boons605/MotoGymkhanaRaceTiming/Documentation/STM32-ARM-development-board-STM32F103C8T6.jpg

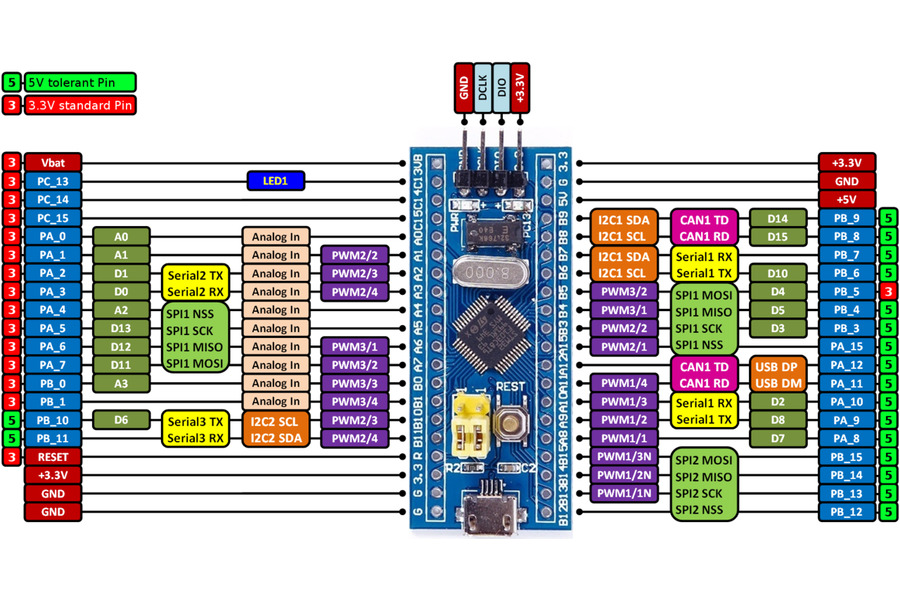
Documentation/STM32-ARM-development-board-STM32F103C8T6.jpg
