boons605/MotoGymkhanaRaceTiming/RiderDetection/Readme.txt

The embedded part of the rider detection was written for the ESP32 platform.
Development hardware used is the ESP32-WROOM-32.
Development environment/framework used is ESP-IDF v4.1-dirty
