boons605/MotoGymkhanaRaceTiming/Timer/README.md

# MotoGymkhanaRaceTiming

This directory contains files for the STM32 software and the supporting PCB
