boons605/MotoGymkhanaRaceTiming/CentralUnit/Deployment/Raspberry-Pi-pinout.png

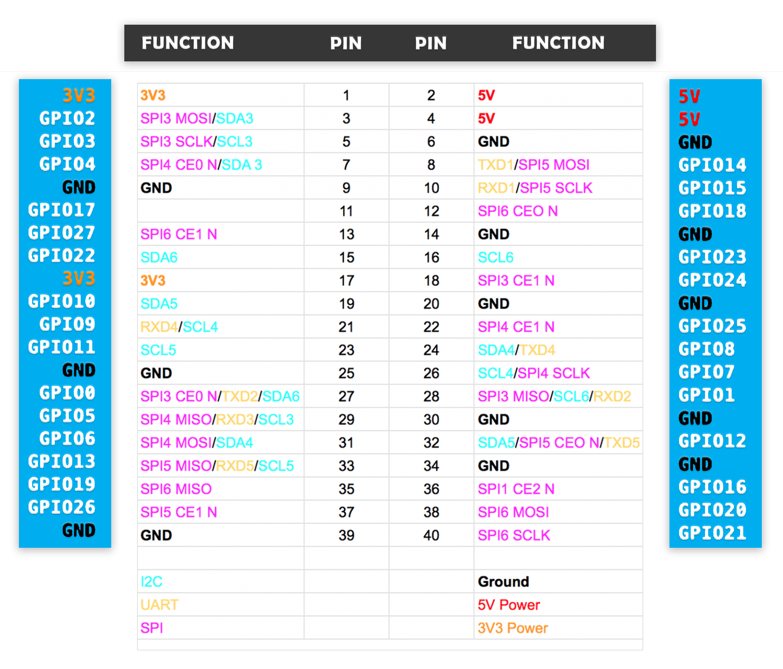
CentralUnit/Deployment/Raspberry-Pi-pinout.png
