boons605/MotoGymkhanaRaceTiming/Documentation/Schematics_STM32-ARM-development-board-STM32F103C8T6.jpg

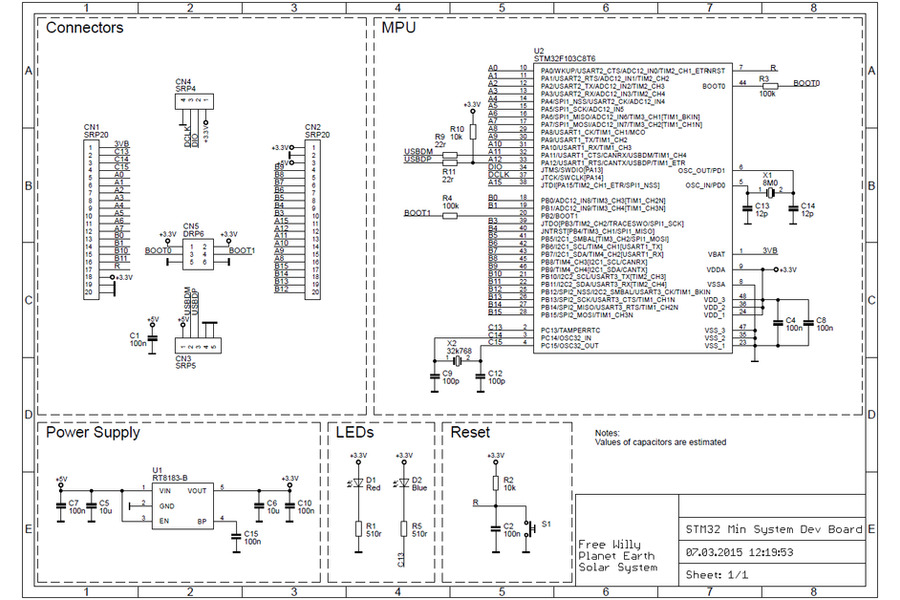
Documentation/Schematics_STM32-ARM-development-board-STM32F103C8T6.jpg
