boons605/MotoGymkhanaRaceTiming/Documentation/Component_diagram.png

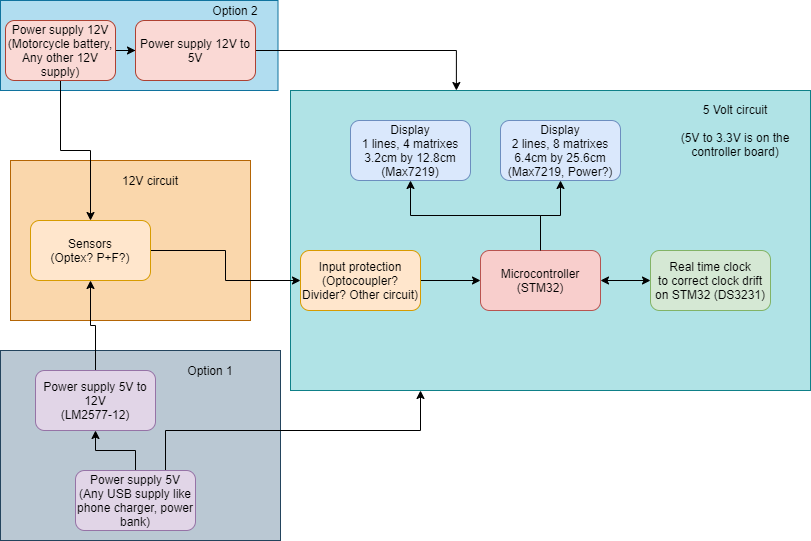
Documentation/Component_diagram.png
