boons605/MotoGymkhanaRaceTiming/(threads)

Thread 3 (2020-05-10):

Dual sensor lap timer

boons605, 2020-05-10:
Dual sensor lap timer:

- Start on interrupt of first sensor
- Stop on interrupt of second sensor

Closed 2020-06-13.

Thread 4 (2020-05-10):

Figure out display options

boons605, 2020-05-10:
Figure out which display options are best

- Large 7-segment (seems a costly option)
- LED Matrix
- E paper?

I-am-not-a-number, 2020-06-22:
ePaper seems an interesting solution!

I was also thinking about building 7 segment displays with LED stripes ... but it seems a lot of effort and I don't have a 3D printer yet.

boons605, 2020-06-22:
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

I've looked at ePaper, and although it seems to be interesting, it is uncertain if the reaction times are low enough and more important: The price. The MAX7219 matrix display solution is almost free and easy to come by. Loads of these displays can be found on AliExpress.

Closed 2022-12-11.

Thread 7 (2020-05-17):

Power supply options - Power bank

boons605, 2020-05-17:
https://www.electronics-lab.com/project/5v-to-12v-step-up-dc-dc-converter/

boons605, 2020-05-17:
https://www.eleccircuit.com/lm2577-5v-to-12v-dc-converter-step-up-voltage-regulator/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

I-am-not-a-number, 2020-06-22:
Hi there,

I'm using an Arduino with an Optex Z2R-400N for a very similar project. The Optex seems to work fine with 9V and the Arduino does, too (the board has a voltage converter for input of 3,3/5 - 12V). The data line of NPN version of the Optex goes to GND, so there's no need to convert the signal down to mircocontroller level ...

Cheers :-)

boons605, 2020-06-22:
Interesting option, the NPN sensor. That might save a few components.
On the other hand: The micorocontroller is protected from accidental wrong connections this way. Accidental 12V would blow it up. Accidental ground won't blow it up now.

I don't see the relevance of the 9V supply: Power banks are easy to come by, battery management is integrated and everyone can charge them. There does not seem to be an equally easy and generic solution for a 9V supply, except for batteries which might not have the greatest capacity to supply and LED display for a longer time.

Most sensors are specced from 10 to 30V. 12V is common enough to be able to use anything that is easily sourceable in any country.

I-am-not-a-number, 2020-07-03:
Thanks for your input!

I have not yet checked how long a 9V battery (that option would save me the power converter parts) would last. I guess it's not long, and I'll go for the power bank option as well.

The goal of my project is the same as yours ... I'm not doing Moto Gymkhana myself, but I'm building this for someone who does.

The timing issue remains to be solved, the milliseconds provided by my arduino (hardware) are off by about 0,04% (measured manually over a longer period of time) and the RTC (DS3231SN) only provides seconds. I thought of aligning "millis()" every seconds with the RTC, but I'm not sure this'll make the timing more accurate ;-)

boons605, 2020-07-04:
I am using the DS3231 to count the seconds and then use a 100us timer based on the 8MHz crystal on the BluePill STM32 board. It helps :-)
You shouldn’t use millis() at all, since it doesn’t increase at 1000us intervals but at 1024us intervals and then compensates for that once every 42ms or so.

The BluePill is cheaper and more powerful than any Arduino board.

0.04% is 24ms over a minute. This solution has been tested to be equally accurate as our €2000,- professional race timing system. Measured with an oscilloscope (PicoScope 4444) it was off by max 80us compared to the simulated trigger.

Anyway. You’re welcome to use my designs or contribute to this project too.

Closed 2020-06-13.

Thread 8 (2020-05-30):

Improve accuracy - 100us timer resolution

boons605, 2020-05-30:
Sometimes a lap is 1ms off.

It seems that this is caused by the fact that TIM2 is set to generate an interrupt every 1ms, but the interrupt of the sensor never comes in exactly at the millisecond boundary.

Therefore, set TIM2 to generate interrupts every 100us and count the interrupts between the start and finish, to account for the remaining fractions of milliseconds and to avoid letting this remainder add up and lead to a 1ms drift over a few rounds.

Closed 2020-06-13.

Thread 9 (2020-06-03):

PCB improvements

boons605, 2020-06-03:
- Add buttons
- Add resistors for voltage divider for LM2577T-ADJ
- Change footprints for display connectors to straight connectors
-

Closed 2021-04-04.

Thread 10 (2020-12-28):

Set up central unit scaffold

CptMalfunction, 2020-12-28:
The general architecture of the system will have a central unit running on a pc, and several edge units running on less powerful hardware.

These edge units are

- Timer: registers when something crosses the detector and returns a timestamp
- ID: registers a driver's bluetooth dongle nearby and sends bluetooth id
- maybe more?

The central unit is responsible for:

- configuring the edge units (for example: which BL ids are riders)
- notifying edge units of events (for example: a rider has left the track)
- consolidating edge unit data into race events (for example:  ID unit registers rider, timing unit registers time, combine into a finish/start time for that rider)
- saving race results

The scaffold should include:

- A CLI project with a version command
- A Timer project that specifies the timing unit interface
- An Id project that specifies the ID unit interface
- A RaceManagement project as a placeholder

Project should be written in C# in .netcore 3.1

Closed 2020-12-30.

Thread 12 (2020-12-30):

Implement event matching

CptMalfunction, 2020-12-30:
The system is going to track the state of the race by events coming in from the timing and rider id units. This means we will have to match timing events to rider id events to be able to couple lap times to riders and to detect when riders leave the track without hitting the end gate.

A race has 4 primitive events:
- start rider id (when a rider is picked up in the start box)
- start timing event (when a rider triggers the timer at the start box)
- end rider id
- end timer

A race has 3 derived events:
- Lap end (when we have matching end events)
- Finish (when we have a matching set of the 4 primitives)
- DNF (when we have matches for the start events, but no ending events)

A rider has 3 possible states:
- Waiting for start (when we have a start rider id event)
- On track (we have a start rider id and a start timer)
- Off track (we have a finish or DNF event for the rider)
-- Off track means our system has stopped keeping track, a rider may enter the start box to be 'Waiting' again

We assume these things about the primitive events:
- start rider id always happens before start timing. Since the rider must calmly enter the start box in a race
- matching end id and timer events may happen in either order (if the id range is much bigger than the stop box)
- matching end id and timer events happen at most 10 seconds apart
- there will be no end id events for riders not currently on track (we can notify the unit on which ids to report when riders start)
- there will be no start id events for riders who are not lining up for the start box (tell riders to keep a safe distance)

The algorithm for keeping track of riders will be:

On start rider id event:
Add a new Waiting rider to the queue

On start timer event:
Take the oldest Waiting rider from the queue, match to the new timer event.
Set rider to On track
if there is no waiting rider, disregard event

On end timer event:
Match to closest end id event (+/-10 secs at most)
if there is no match, store event
if there is a match, issue a new Lap end event

On end id event
Match to closest end timer event (+/-10 secs at most)
if there is no match, store event
if there is a match, issue a new Lap end event

On Lap end event:
Match to riders currently on track
If it matches to the oldest on track, Issue a Finish event
If it matches to a younger on track rider, issue Finish event for matched driver. Issue DNF events for all older on track drivers

This algorithm should be implement in RaceManagement. Covered by unit tests and it should be possible to run a simulated race from the CLI by providing an events list in txt form

boons605, 2020-12-31:
As discussed on discord:

- Permission to start, rider ID unit should be able to control a traffic light for feedback to the rider.
- Result display event to timing unit or generic display unit (separate interface? To allow display-only devices)
- Single sensor operation, for example for world courses, online EC, GP8 competitions.

boons605, 2021-01-01:
What to do on a failure of the ID unit or timer unit communication?

On some events, we may be able to recover by restarting the communication, or restarting the application.
Should we store 'current' runs somewhere in order to facilitate sort of graceful restart?

CptMalfunction, 2021-01-09:
Added events for rider ready to start and rider finished to allow for a simple 'ready' signal at start and time display at finish

Closed 2021-01-24.

Thread 13 (2020-12-30):

Implement timer communication

boons605, 2020-12-30:
The timer needs to be able to communicate over UART

For now, 2 functions are sufficient:

* Timestamp communication
  * Unsollicited
  * Include data about sensor (start, stop or lap finished for lap timer operation mode)
* Keepalive to monitor communication
  * Two-way communication
  * No effect, other than for the central unit to monitor communication
  * Contains information about the configuration of the timer (number of sensors, RTC present or not, operation mode)

Closed 2021-04-04.

Thread 14 (2020-12-30):

Communication framework

boons605, 2020-12-30:
Implementation of communication with field units

* Must support Serial connection
* Must support Xbee communcation
* Must abstract Xbee communication and serial communcation to the point where the interface consists of 3 items
  * DataReceived event
  * Failure event
  * SendData method, accepting a byte array

Closed 2021-01-03.

Thread 15 (2020-12-31):

Web service for UI?

boons605, 2020-12-31:
We talked about a web interface for the UI. Creating this issue to collect ideas and links to interesting resources.

- .NET Core web service on Linux (Pi) https://docs.microsoft.com/en-us/aspnet/core/host-and-deploy/linux-nginx?view=aspnetcore-5.0
- Web API in .NET Core
https://docs.microsoft.com/en-us/aspnet/core/tutorials/first-web-api?view=aspnetcore-5.0&tabs=visual-studio

CptMalfunction, 2021-03-07:
Currently im thinking we split this up in 2 projects. The actual api in asp.net core, and the web ui in a blazor project

CptMalfunction, 2021-03-28:
So now that i've gotten a single endpoint up and running what endpoints do we want? I've got a few here:

- Race monitoring endpoints:
-- GET /RaceState: returns a json that contains riders on track, riders waiting for start. And any device events waitign for a match
-- GET /Laps: returns a json with a list of all the driven laps (including DNF) since the unit was turned on
-- GET /BestLaps: Returns a json with the best lap per driver, sorted by lap time

- Management endpoints:
-- POST /AddRiders: takes a json with a list of all riders that should be tracked by the system
-- DELETE /Rider: takes a rider id as a query param and stops tracking this rider for the current race
-- POST /Config: takes a json that specifies a full race config (id units and timing unit details). Clears the current race state and (re) starts the race with the new settings
-- GET /Lock: takes 'open' or 'closed' as a query parameter. If closed no new riders can start

boons605, 2021-03-28:
I would like to opt for the option to integrate DSQ and Penalty points and to register those as events with a timestamp (and to be able to undo those and therefore to list them in order of time). Penalty point events could have an amount (configurable?) category?

Could be really helpful in identifying what exactly went wrong: For the rider to improve themselves and when handling disputes after the race.

Romke Boonstra

Sent from my iPhone

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

boons605, 2021-03-28:
Maybe add some management operations for listing riders, modifying riders.

Modifying race results maybe?

CptMalfunction, 2021-04-11:
I think ill make the management endpoints into a differnt issue. For now im just doing the andpoints for the state and the laps

Closed 2021-04-22.

Thread 17 (2021-01-02):

Implement Rider ID device communication

boons605, 2021-01-02:
Implementation of Rider ID device communication for the ESP32 based iBeacon rider identification.

The scaffold was already set up in issue #10, now implementation of rider ID unit interface is to be written:

* Establish communication
* Keepalive every 1000ms, unless a message is received during that time
* Allow adding and removing of known beacons
* Define conditions to consider rider 'in range' (have configurable detection range?)

Closed 2021-01-31.

Thread 18 (2021-01-02):

Data model

boons605, 2021-01-02:
While in issue #12 the event matching is implemented and in issue #17 the rider ID communication is implemented, the idea arose to keep the data model in a separate project, to allow use by future components.

Uses for this could be:

* Storing results in a database
* Communication in a UI
* REST API
* Publication
* Future expansions

For this, we need to agree upon a suitable data model at least we have:

* Rider
  * Has 1: Beacon
  * Has 1: Name
* Beacon
  * Has 1: BLE identifier (6 bytes)
  * Has 1: Transmit power (signal strength at 1m)
  * Has 1: Transmit power correction factor (for cheap chinese beacons)
  * Has 1: Detected signal strength
  * Belongs to 1 rider
* Race Event:
  * Is either a: Timestamp, Rider ID, Penalty event, DNF Events, DSQ Event
  * Always has 1: Date/time received (for rough linking of future additional events)
    * Timestamp Event
      * Has 1: timestamp in microseconds
      * Has 1: Sensor ID (start or stop)
    * Rider ID event
      * Has 1: Beacon
      * Has 1: Sensor ID
    * DNF Event
    * Penalty Event (not implemented for now)
      * Has 1: Type (configurable?)
    * DSQ Event (not implemented for now)
* Run
  * Has 1 Rider
  * Has a list of Race Events
  * Date/Time created
  * Date/Time last updated
* RaceDay? (not for now)
* Competition? (not for now)

Closed 2021-01-31.

Thread 19 (2021-01-02):

Carrier PCB for Rider ID unit

boons605, 2021-01-02:
For the Rider ID unit, we need a carrier PCB to carry the ESP32 and, for one of the gates, the Xbee module.

The PCB should:

* Carry the ESP32
* Carry the Xbee module
* Provide an option for direct serial connection to the central unit
* Have a MicroUSB connection for power
* Be able to control an LED light?

Closed 2021-04-04.

Thread 29 (2021-03-15):

Central unit PCB

boons605, 2021-03-15:
PCB for some interconnections between components:

* Carries an Xbee module
* Has a 40-pin header to connect to the RPi
* Has an Rx/Tx/Gnd header to connect to the timer unit
* Has a connection to the terminal port of the RPi
* LEDs for the Xbee module RSSI and ASSOC
* Power LED

Closed 2021-04-04.

Thread 31 (2021-04-04):

Race management with business logic

boons605, 2021-04-04:
Features needed for usability at a race day:

Created Issue #33
> * Allow user-generated DNF

Created Issue #32
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

Created issue #35
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

Created Issue #36
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

Created Issue #34
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

boons605, 2021-04-04:
Created new issues to split up this issue

Closed 2021-04-04.

Thread 58 (2021-05-22):

Interact with gymkhana website

CptMalfunction, 2021-05-22:
For documentation on available endpojnts see timing.motogymkhana.nl/handleiding_scorebord.pdf.

At https://timing.motogymkhana.nl/ there is a web api that can show times and who is currently on track. We can populate this page by using the state from the racetracking endpoints available on the web api of the central unit.

We should implement a small auxiliary program that polls the web api of the central unit and posts results to the gymkhana website.

Acceptance criteria:

- When a new rider enters the track the "Nu aan het rijden" table is updated
- When a rider finishes a lap the rider is removed from the "Nu aan het rijden" table and the time is added to both time tables
- When a rider receives a DNF the rider is removed from the "Nu aan het rijden" table and a DNF row is added to the timing tables
- When a rider receives a DSQ the rider is removed from the "Nu aan het rijden" table and DSQ row is added to the timing tables

Notes: there does not appear to be a way to clear the board. Should we add such an endpoint and clear on startup?

CptMalfunction, 2021-05-23:
> Up for discussion with Paul:
>
> Why aren't DNFs or DSQs registered as time with the attribut 'DNF' or 'DSQ'? Wouldn't you want to have these times registered anyway? The rider has started and there should be some kind of evidence that this has taken place.

The penalty endpoint allows you to record dnfs and dsq's. Should really be in the acceptance criteria

Closed 2022-12-11.

Thread 76 (2023-11-17):

Picking riders from ordered start list

boons605, 2023-11-17:
This function is already in, but the issue is created anyway, to be able to record how this is verified

Als wedstrijdleider wil ik rijders uit een lijst kunnen kiezen die in het startvak staan om ze toestemming te geven te starten

Closed 2024-04-14.

Thread 77 (2023-11-17):

Changing order of start list

boons605, 2023-11-17:
This function is already in, but the issue is created anyway, to be able to record how this is verified

Als wedstrijdleider wil ik last minute wijzigingen in de startvolgorde kunnen aanbrengen, want motoren gaan stuk

Closed 2024-02-18.

Thread 78 (2023-11-17):

Stop box functions

boons605, 2023-11-17:
This function is already in, but the issue is created anyway, to be able to record how this is verified

Als wedstrijdleider wil ik de eerst gestarte rijder die in het parcours is gepresenteerd krijgen zodra er een rijder in het stopvak verschijnt want dat is de meest waarschijnlijke optie

Als wedstrijdleider wil ik, indien het niet de eerst gestarte rijder is die in het stopvak staat, kunnen kiezen uit rijders in het parcours

Als wedstrijdleider wil ik een timestamp kunnen negeren, want valse detecties komen voor

Closed 2024-04-14.

Thread 79 (2023-11-17):

Adding penalties while racing

boons605, 2023-11-17:
Als wedstrijdleider wil ik tijdens het rijden strafpunten kunnen invoeren, zodat het resultaat direct de strafpunten bevat

Als wedstrijdleider wil ik kort na het finishen strafpunten kunnen invoeren, omdat mensen doorschieten in het stopvak of op andere wijze strafpunten kunnen verdienen

CptMalfunction, 2023-11-19:
Het is al mogelijk om:

- DNF te geven via POST /DNF
- DSQ te geven via POST /DSQ
- Strafseconden te geven via Post /Penalty

Al deze penalties worden teogepast op de huidige lap van de rider als deze nu aan het rijden is, of op het meest recente gereden lap. Daar hoeft de ui geen keuze in te maken. Als de endpoints aangeroepen worden tijden een lap dan komt de penalty op dat lap anders komen de penalties op het meest recente lap

Als een lap afgerond is dan kunnen de panelties in het lap object uitgelezen worden uit GET /Laps of GET /BestLapsByRider.

Wat er nog ontbreekt is een endpoint om de penalties uit te lezen die op het huidige lap toegepast worden terwijl dat lap nog bezig is. Dat ga ik maken voor deze issue

CptMalfunction, 2023-11-19:
Nieuw endpoint:

- GET /Penalties
- Geeft alle openstaande penalties terug voor rijders die nu aan een lap bezig zijn.
- Output: ```{
    "0694d10b-3cc4-424b-823a-2b45b1b3455f": [
        {
            "reason": "",
            "seconds": 1,
            "staffName": "UI",
            "time": "2023-11-19T15:44:03.7680777+01:00",
            "eventId": "5b148b1b-c83c-4238-9e12-fab9d80a146c",
            "rider": {
                "name": "Test",
                "id": "0694d10b-3cc4-424b-823a-2b45b1b3455f"
            },
            "type": "PenaltyEvent"
        }
    ]
}```

Om het aantal seconden o[ te halen zou je zoiets doen als `penalties['rider guid'][0].seconds`

rbf660, 2023-11-20:
Is het ook mogelijk om status van DSQ penalty toe te voegen?

Closed 2024-02-18.

Thread 80 (2023-11-17):

Multiple penalty types to be defined

boons605, 2023-11-17:
Als wedstrijdleider wil ik meerdere soorten penalties kunnen definiëren met meerdere kenmerken, omdat verschillende vergrijpen verschillende sancties kennen.
•	Kleur (geel/rood)
•	Seconden (1/3)

Closed 2024-04-14.

Thread 81 (2023-11-17):

Rider feedback in stopbox

boons605, 2023-11-17:
Als rijder wil ik direct terugkoppeling over de gereden tijd zonder strafpunten, want er kan discussie zijn onder de wedstrijdleiding

Control display hardware

Maybe make time available on a separate endpoint/page to allow the use of an iPad or similar device as a rider display?

Closed 2024-04-14.

Thread 82 (2023-11-17):

State restore after startup

boons605, 2023-11-17:
Als wedstrijdleider wil ik de toestand van het systeem kunnen herstellen na een herstart, omdat kabels losraken of rijders de apparatuur om rijden

- Currently running laps shall be restored
   - Including penalties
- Previous laps shall be restored
- Start list/rider list shall be restored

Closed 2024-04-14.

Thread 88 (2023-12-09):

ongebruikte end time events weg gooien

CptMalfunction, 2023-12-09:
Het is nu niet mogelijk om end time events die zeker niet gebruikt gaan worden permanent te verwijderen van het systeem. Het wordt dan voor de ui steeds moeilijker om de end time events te vinden die wel horen bij de rijders op de baan.

de api krijgt dit nieuwe endpoint:

- DELETE /PendingTime?eventId=<guid>

In de query parameter gaat het event id van een event uit het GET /PendingTimes endpoint. Na het aanroepen van dit DELETE endpoint zal het event met het aangegeven id niet meer terug komen in de response van GET /PendingTimes

Closed 2023-12-09.

Thread 89 (2024-02-17):

Data from timer received twice

boons605, 2024-02-17:
Weird issue with timestamps being 'received' twice with the same data, one immediately after matching time and rider

1. Clear rider for start
2. Trigger gate to Start rider
3. Trigger gate to stop rider
4. Confirm finish time

`
2024-02-17 19:30:41,614 [4] INFO  RaceManagement.RaceManager [(null)] - Rider Claud van Gessel can start
2024-02-17 19:30:41,706 [12] INFO  WebAPI.Controllers.RaceTrackingController [(null)] - addin rider Richard van Schouwenburg, 6522e607-0eee-4e8f-9ea7-898007ad4eb0
2024-02-17 19:30:48,438 [6] INFO  Communication.AbstractCommunicatingUnit [(null)] - Got timestamp for timer: Command type 101;
Data length: 5
CRC: 17534
Data: 30-01-57-BA-01

2024-02-17 19:30:48,460 [7] INFO  Communication.AbstractCommunicatingUnit [(null)] - Triggering timing event for timerUnit
2024-02-17 19:30:48,461 [7] INFO  Communication.AbstractCommunicatingUnit [(null)] - Triggered timing event for timerUnit
2024-02-17 19:30:48,465 [4] INFO  RaceManagement.RaceTracker [(null)] - Rider f96116e7-639b-45f1-aae0-1f3d7c52fe5b is now on track with timestamp 3126264112
2024-02-17 19:30:48,472 [4] INFO  RaceManagement.RaceManager [(null)] - Start box is empty
2024-02-17 19:30:53,786 [6] INFO  Communication.AbstractCommunicatingUnit [(null)] - Got timestamp for timer: Command type 101;
Data length: 5
CRC: 59881
Data: 4C-B1-A8-BA-02

2024-02-17 19:30:53,803 [7] INFO  Communication.AbstractCommunicatingUnit [(null)] - Triggering timing event for timerUnit
2024-02-17 19:30:53,804 [7] INFO  Communication.AbstractCommunicatingUnit [(null)] - Triggered timing event for timerUnit
2024-02-17 19:31:06,861 [4] INFO  RaceManagement.RaceManager [(null)] - Rider Claud van Gessel finished with a lap time of 5353500 microseconds
2024-02-17 19:31:06,893 [6] INFO  Communication.AbstractCommunicatingUnit [(null)] - Got timestamp for timer: Command type 101;
Data length: 5
CRC: 59881
Data: 4C-B1-A8-BA-02

2024-02-17 19:31:06,895 [7] INFO  Communication.AbstractCommunicatingUnit [(null)] - Triggering timing event for timerUnit
2024-02-17 19:31:06,896 [7] INFO  Communication.AbstractCommunicatingUnit [(null)] - Triggered timing event for timerUnit
2024-02-17 19:31:06,896 [4] INFO  RaceManagement.RaceTracker [(null)] - Discarding timestamp from gate 2 at 3131617612 us, no riders on track
^C
ubuntu@ubuntu:~/motogymkhana$
`

boons605, 2024-02-18:
Fixed in #83

Closed 2024-02-18.
