boons605/MotoGymkhanaRaceTiming/RiderDetection/PCB/RiderDetection/RiderDetection.kicad_pcb

## KiCad design RiderDetection/PCB/RiderDetection/RiderDetection.kicad_pcb (2021-03-23)

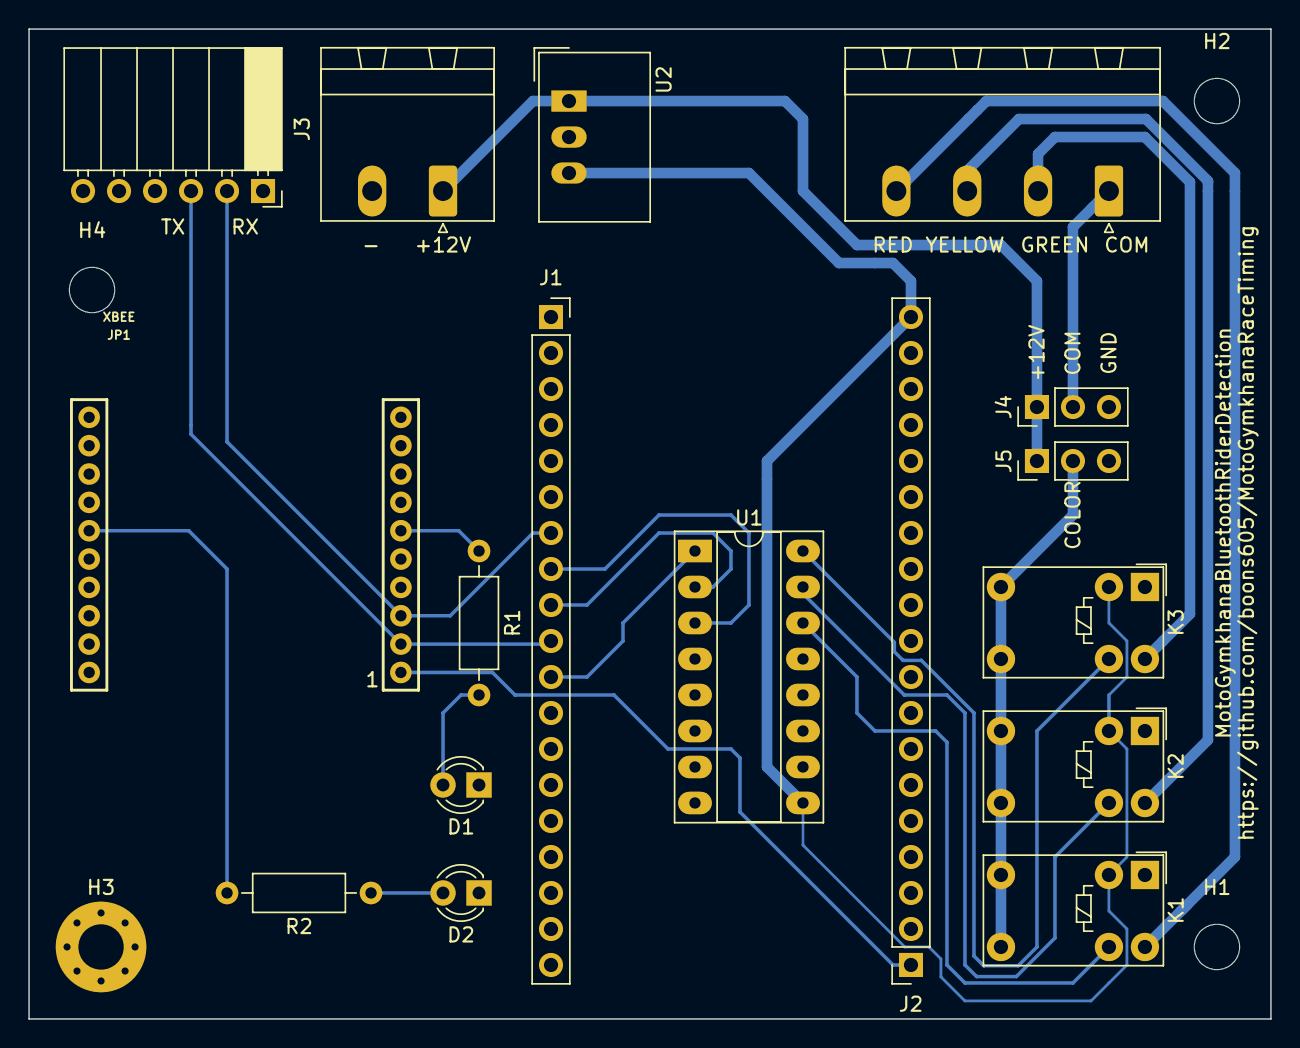
[picture p5: board RiderDetection.kicad_pcb from above]

Board: 2 copper layers, 87.6 x 69.8 mm, 21 parts (0 on the bottom side), 21 nets.

Parts:
D1, D2: LED; LED_D3.0mm
H1, H2, H4: MountingHole; MountingHole_3.2mm_M3
H3: MountingHole_Pad; MountingHole_3.2mm_M3_Pad_Via
J1, J2: Conn_01x19; PinSocket_1x19_P2.54mm_Vertical
J3: Conn_01x06; PinSocket_1x06_P2.54mm_Horizontal
J4, J5: Conn_01x03_Male; PinHeader_1x03_P2.54mm_Vertical
JP1: XBEE
K1, K2, K3: G5V-1; Relay_SPDT_Omron_G5V-1
PWR0: Screw_Terminal_01x02; PhoenixContact_MSTBA_2,5_2-G_1x02_P5.00mm_Horizontal
R1, R2: 330R; R_Axial_DIN0207_L6.3mm_D2.5mm_P10.16mm_Horizontal
STARTLIGHT0: Screw_Terminal_01x04; PhoenixContact_MSTBA_2,5_4-G_1x04_P5.00mm_Horizontal
U1: ULN2003A; DIP-16_W7.62mm_Socket_LongPads
U2: TSR_1-2450; Converter_DCDC_TRACO_TSR-1_THT

Connections:
+3V3: J2.1, JP1.1
+5V: J2.19, K1.2, K2.2, K3.2, U1.9, U2.3
+12V: J4.1, J5.1, PWR0.1, U2.1
COL_GRN: K3.10, STARTLIGHT0.2
COL_RD: K1.10, STARTLIGHT0.4
COL_YW: K2.10, STARTLIGHT0.3
GND: D1.1, D2.1, H3.1, J1.19, J3.6, J4.3, J5.3, JP1.10, PWR0.2, U1.8, U2.2
unnamed: D1.2, R1.2
unnamed: D2.2, R2.1
unnamed: J1.8, U1.3
unnamed: J1.9, U1.2
unnamed: J1.11, U1.1
unnamed: JP1.6, R1.1
unnamed: JP1.15, R2.2
unnamed: K1.9, U1.14
unnamed: K2.9, U1.15
unnamed: K3.9, U1.16
RXD: J1.7, J3.2, JP1.3
START_COLOR_COM: J5.2, K1.5, K1.6, K2.5, K2.6, K3.5, K3.6
START_COM: J4.2, STARTLIGHT0.1
TXD: J1.10, J3.3, JP1.2
