boons605/MotoGymkhanaRaceTiming/Timer/PCB/MotoGymkhanaRaceTiming/MotoGymkhanaRaceTiming.kicad_pcb

## KiCad design Timer/PCB/MotoGymkhanaRaceTiming/MotoGymkhanaRaceTiming.kicad_pcb (2021-03-23)

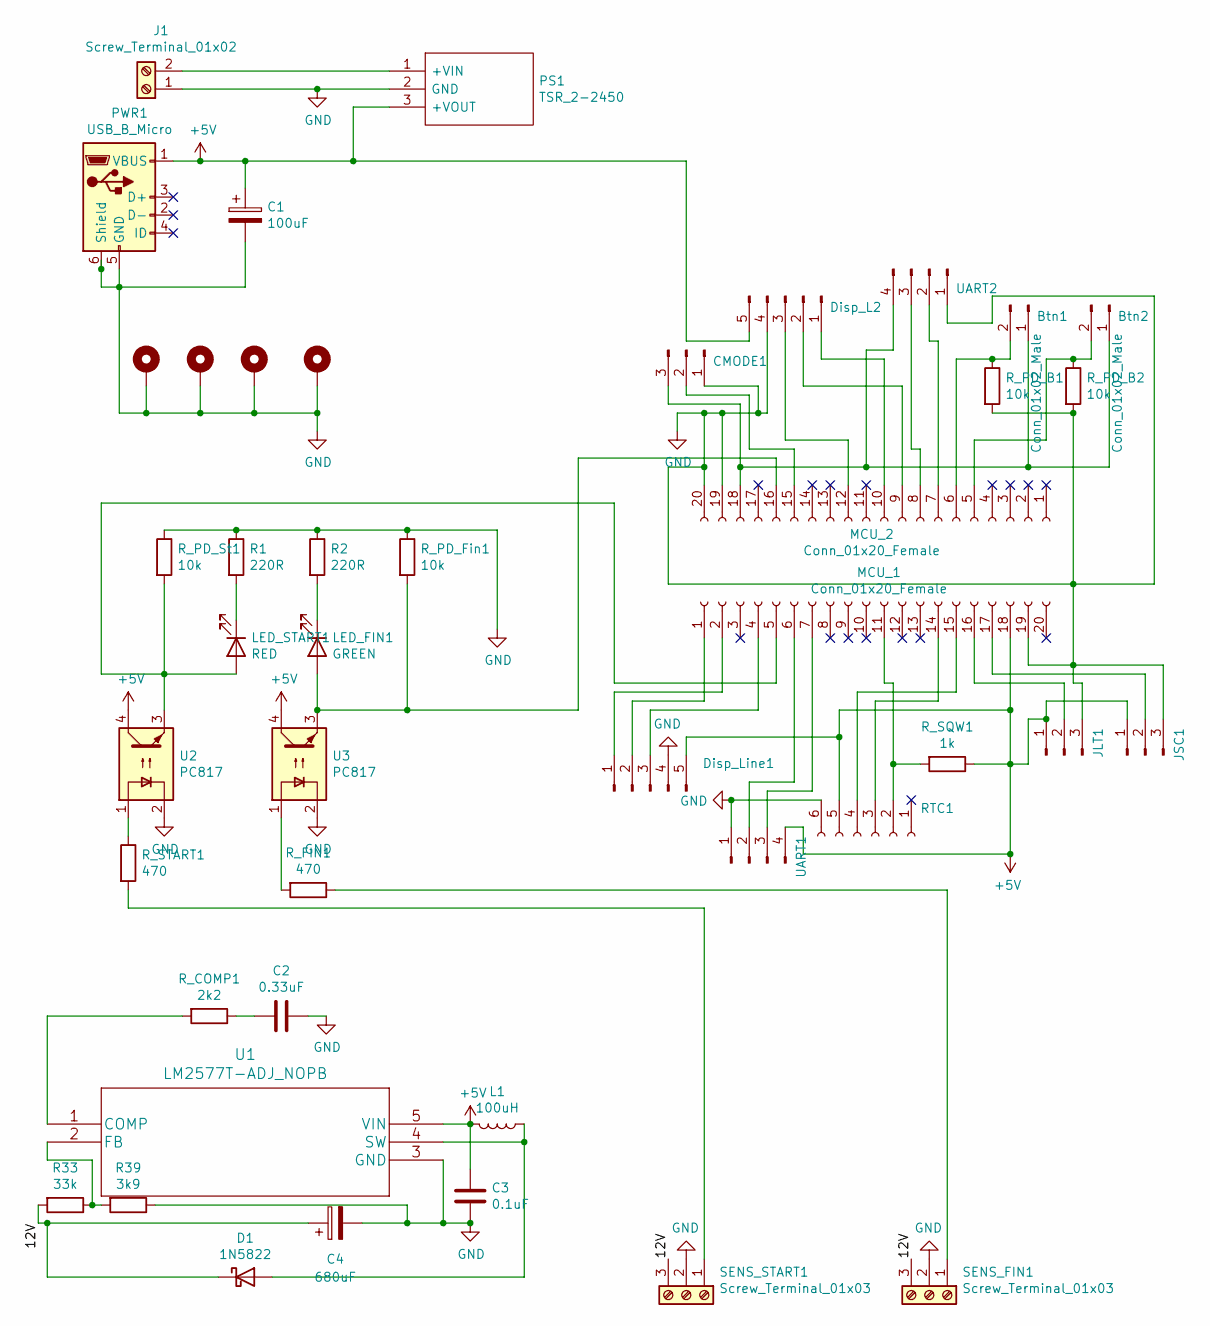
[picture p6: schematic MotoGymkhanaRaceTiming.sch]

Parts:
Btn1, Btn2: Conn_01x02_Male; PinHeader_1x02_P2.54mm_Vertical
C1: 100uF; CP_Radial_D8.0mm_P5.00mm
C2: 0.33uF; C_Disc_D4.7mm_W2.5mm_P5.00mm
C3: 0.1uF; C_Disc_D4.7mm_W2.5mm_P5.00mm
C4: 680uF; CP_Radial_D10.0mm_P5.00mm
CMODE1: Conn_01x03_Male; PinHeader_1x03_P2.54mm_Vertical
D1: 1N5822; D_DO-201AD_P15.24mm_Horizontal
Disp_L2: Conn_01x05_Male; DisplayLineConnector
Disp_Line1: Conn_01x05_Male; DisplayLineConnector
H1, H2, H3, H4: MountingHole_Pad; MountingHole_3.2mm_M3_Pad_Via
J1: Screw_Terminal_01x02; PhoenixContact_MSTBA_2,5_2-G_1x02_P5.00mm_Horizontal
JLT1: Conn_01x03_Male; PinHeader_1x03_P2.54mm_Vertical
JSC1: Conn_01x03_Male; PinHeader_1x03_P2.54mm_Vertical
L1: 100uH; L_Radial_D7.0mm_P3.00mm
LED_FIN1: GREEN; LED_D5.0mm
LED_START1: RED; LED_D5.0mm
MCU_1, MCU_2: Conn_01x20_Female; PinSocket_1x20_P2.54mm_Vertical
PS1: TSR_2-2450; TSR-2; Manufacturer_Part_Number TSR 2-2450; Mouser Part Number 495-TSR2-2450
PWR1: USB_B_Micro; USB_Micro-B_Wuerth_614105150721_Vertical_CircularHoles
R1, R2: 220R; R_Axial_DIN0207_L6.3mm_D2.5mm_P10.16mm_Horizontal
R33: 33k; R_Axial_DIN0207_L6.3mm_D2.5mm_P10.16mm_Horizontal
R39: 3k9; R_Axial_DIN0207_L6.3mm_D2.5mm_P10.16mm_Horizontal
RTC1: Conn_01x06_Female; RTC_Socket
R_COMP1: 2k2; R_Axial_DIN0207_L6.3mm_D2.5mm_P10.16mm_Horizontal
R_FIN1: 470; R_Axial_DIN0207_L6.3mm_D2.5mm_P10.16mm_Horizontal
R_PD_B1, R_PD_B2: 10k; R_Axial_DIN0207_L6.3mm_D2.5mm_P10.16mm_Horizontal
R_PD_Fin1: 10k; R_Axial_DIN0207_L6.3mm_D2.5mm_P10.16mm_Horizontal
R_PD_St1: 10k; R_Axial_DIN0207_L6.3mm_D2.5mm_P10.16mm_Horizontal
R_SQW1: 1k; R_Axial_DIN0207_L6.3mm_D2.5mm_P10.16mm_Horizontal
R_START1: 470; R_Axial_DIN0207_L6.3mm_D2.5mm_P10.16mm_Horizontal
SENS_FIN1: Screw_Terminal_01x03; SensorConnector
SENS_START1: Screw_Terminal_01x03; SensorConnector
U1: LM2577T-ADJ_NOPB; LM2577T-ADJ&slash_NOPB
U2, U3: PC817; DIP-4_W7.62mm
UART1, UART2: Conn_01x04_Male; UART

Connections:
+5V: C1.1, C3.1, Disp_L2.5, Disp_Line1.5, JLT1.1, JSC1.1, L1.2, MCU_1.18, PS1.3 (+VOUT), PWR1.1 (VBUS), RTC1.5, R_SQW1.1, U1.5 (VIN), U2.4, U3.4, UART1.4
/12V: C4.1, D1.1 (K), R33.2, SENS_FIN1.3, SENS_START1.3
GND: C1.2, C2.1, C3.2, C4.2, CMODE1.1, Disp_L2.4, Disp_Line1.4, H1.1, H2.1, H3.1, H4.1, J1.1, JLT1.3, JSC1.3, MCU_1.19, MCU_2.19, MCU_2.20, PS1.2 (GND), PWR1.5 (GND), PWR1.6 (Shield), R1.1, R2.1, R39.1, RTC1.6, R_PD_B1.2, R_PD_B2.2, R_PD_Fin1.1, R_PD_St1.1, SENS_FIN1.2, SENS_START1.2, U1.3 (GND), U2.2, U3.2, UART1.1, UART2.1
unnamed: Btn1.1, Btn2.1, CMODE1.3, MCU_2.18, UART2.4
unnamed: Btn1.2, MCU_2.6, R_PD_B1.1
unnamed: Btn2.2, MCU_2.5, R_PD_B2.1
unnamed: C2.2, R_COMP1.1
unnamed: CMODE1.2, MCU_2.15
unnamed: D1.2 (A), L1.1, U1.4 (SW)
unnamed: Disp_L2.1, MCU_2.10
unnamed: Disp_L2.2, MCU_2.9
unnamed: Disp_L2.3, MCU_2.12
unnamed: Disp_Line1.1, MCU_1.2
unnamed: Disp_Line1.2, MCU_1.1
unnamed: Disp_Line1.3, MCU_1.4
unnamed: J1.2, PS1.1 (+VIN)
unnamed: JLT1.2, MCU_1.16
unnamed: JSC1.2, MCU_1.17
unnamed: LED_FIN1.1 (K), R2.2
unnamed: LED_FIN1.2 (A), MCU_2.16, R_PD_Fin1.2, U3.3
unnamed: LED_START1.1 (K), R1.2
unnamed: LED_START1.2 (A), MCU_1.5, R_PD_St1.2, U2.3
unnamed: MCU_1.6, UART1.2
unnamed: MCU_1.7, UART1.3
unnamed: MCU_1.11, RTC1.2, R_SQW1.2
unnamed: MCU_1.14, RTC1.3
unnamed: MCU_1.15, RTC1.4
unnamed: MCU_2.7, UART2.2
unnamed: MCU_2.8, UART2.3
unnamed: R33.1, R39.2, U1.2 (FB)
unnamed: R_COMP1.2, U1.1 (COMP)
unnamed: R_FIN1.1, SENS_FIN1.1
unnamed: R_FIN1.2, U3.1
unnamed: R_START1.1, U2.1
unnamed: R_START1.2, SENS_START1.1

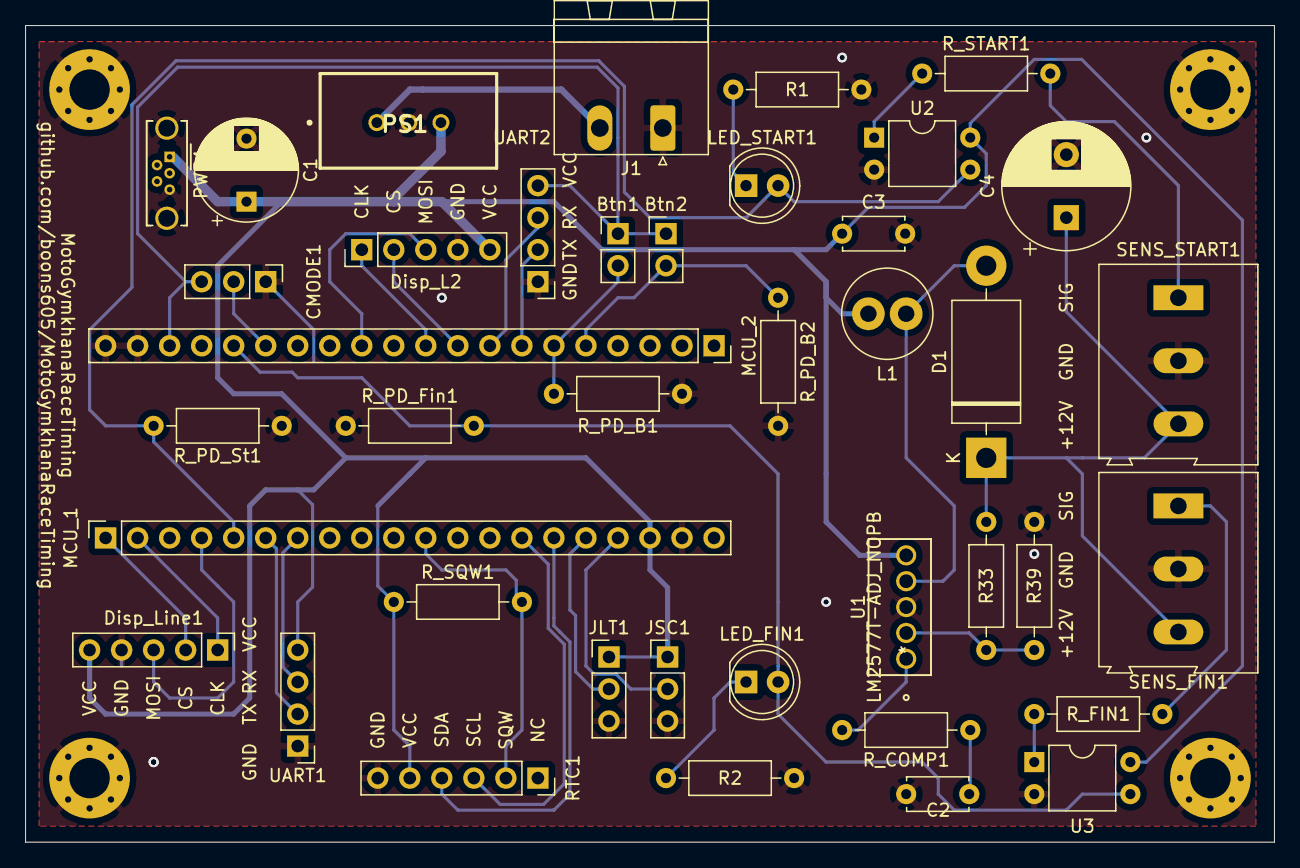
[picture p7: board MotoGymkhanaRaceTiming.kicad_pcb from above]

Board: 2 copper layers, 99.1 x 64.8 mm, 44 parts (0 on the bottom side), 35 nets.
