boons605/MotoGymkhanaRaceTiming/CentralUnit/PCB/CentralUnit/CentralUnit.kicad_pcb

## KiCad design CentralUnit/PCB/CentralUnit/CentralUnit.kicad_pcb (2021-03-23)

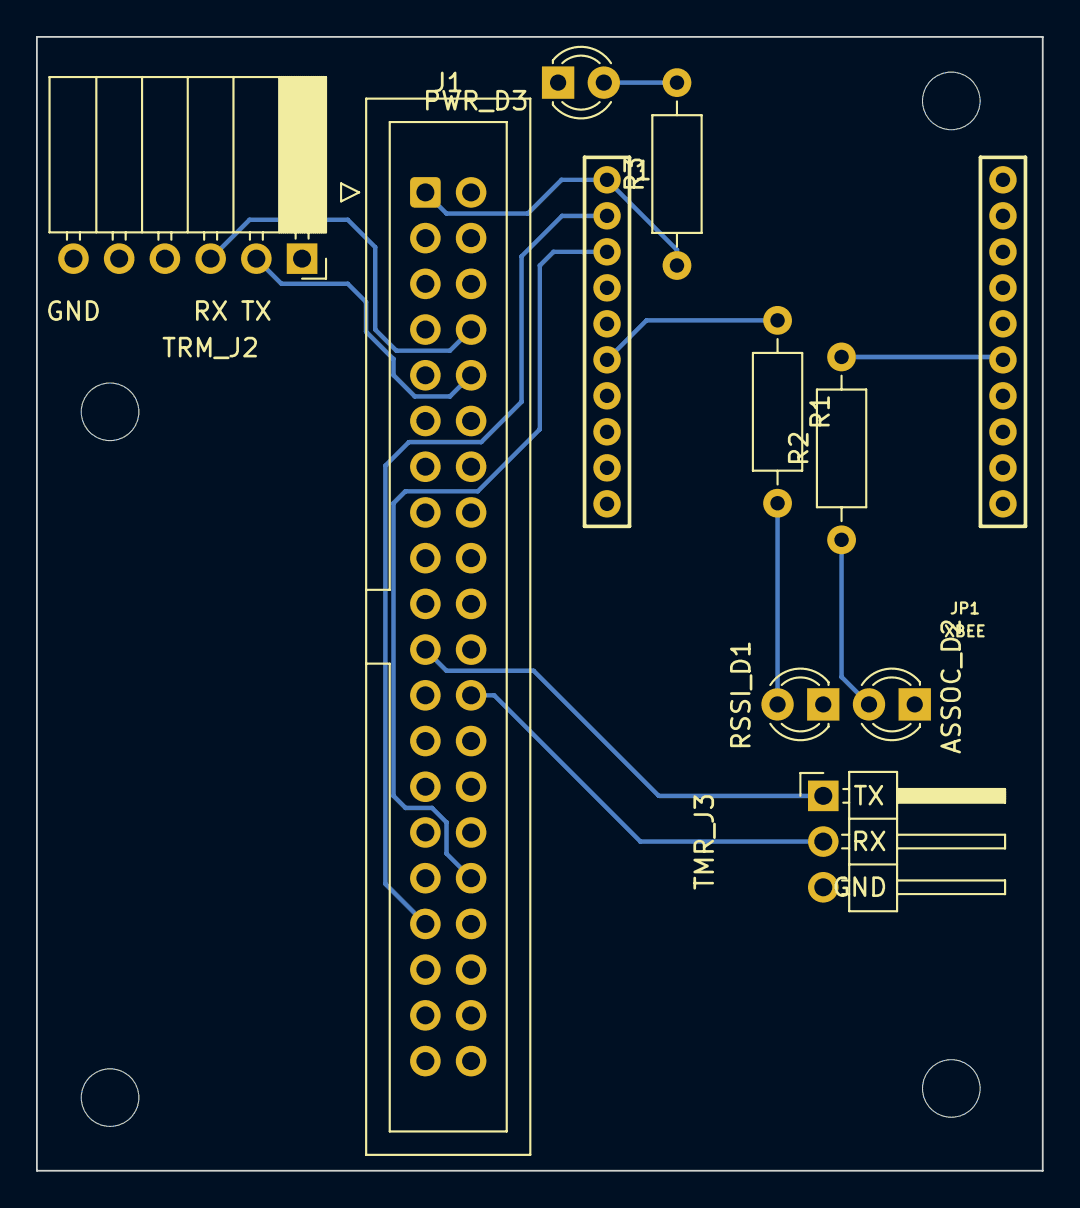
[picture p8: board CentralUnit.kicad_pcb from above]

Board: 2 copper layers, 55.9 x 63.0 mm, 14 parts (0 on the bottom side), 13 nets.

Parts:
ASSOC_D2: LED; LED_D3.0mm
H1, H2, H3, H4: MountingHole; MountingHole_3.2mm_M3
J1: Conn_02x20_Odd_Even; IDC-Header_2x20_P2.54mm_Vertical
JP1: XBEE
PWR_D3: LED; LED_D3.0mm
R1, R2, R3: 160R; R_Axial_DIN0207_L6.3mm_D2.5mm_P10.16mm_Horizontal
RSSI_D1: LED; LED_D3.0mm
TMR_J3: Conn_01x03_Male; PinHeader_1x03_P2.54mm_Horizontal
TRM_J2: Conn_01x06; PinSocket_1x06_P2.54mm_Horizontal

Connections:
+3V3: J1.1, JP1.1, R3.1
GND: ASSOC_D2.1, J1.39, JP1.10, PWR_D3.1, RSSI_D1.1, TMR_J3.3, TRM_J2.6
unnamed: ASSOC_D2.2, R2.1
unnamed: JP1.6, R1.1
unnamed: JP1.15, R2.2
unnamed: PWR_D3.2, R3.2
unnamed: R1.2, RSSI_D1.2
TMR_RX: J1.24, TMR_J3.2
TMR_TX: J1.21, TMR_J3.1
TRM_RX: J1.8, TRM_J2.3
TRM_TX: J1.10, TRM_J2.2
XBEE_RX: J1.32, JP1.3
XBEE_TX: J1.33, JP1.2
