boons605/MotoGymkhanaRaceTiming/Timer/Core/Src/main.c

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

/* Includes ------------------------------------------------------------------*/
#include "main.h"

/* USER CODE BEGIN Includes */
#include "TimeMgmt.h"
#include "Configuration.h"
#include "RaceTiming.h"
#include "Inputs.h"
#include "UARTBuffer.h"
#include <string.h>
/* USER CODE END Includes */


/* USER CODE BEGIN PV */
uint8_t uartData[14] = {0};
volatile uint8_t uartTxIndex = 0;

/* USER CODE END PV */

void SystemClock_Config(void);
static void MX_GPIO_Init(void);
static void MX_USART1_UART_Init(void);
static void MX_TIM2_Init(void);
static void MX_I2C1_Init(void);
static void MX_SPI2_Init(void);
static void MX_SPI1_Init(void);
static void MX_USART2_UART_Init(void);
/**
  * @brief  The application entry point.
  * @retval int
  */
int main(void)
{
    /* MCU Configuration--------------------------------------------------------*/

    /* Reset of all peripherals, Initializes the Flash interface and the Systick. */


    LL_APB2_GRP1_EnableClock(LL_APB2_GRP1_PERIPH_AFIO);
    LL_APB1_GRP1_EnableClock(LL_APB1_GRP1_PERIPH_PWR);

    NVIC_SetPriorityGrouping(NVIC_PRIORITYGROUP_4);

    /* System interrupt init*/

    /** NOJTAG: JTAG-DP Disabled and SW-DP Enabled
    */
    LL_GPIO_AF_Remap_SWJ_NOJTAG();

    /* Configure the system clock */
    SystemClock_Config();

    /* Initialize all configured peripherals */
    MX_GPIO_Init();
    MX_USART1_UART_Init();
    MX_TIM2_Init();
    MX_I2C1_Init();
    MX_SPI2_Init();
    MX_SPI1_Init();
    MX_USART2_UART_Init();
    /* USER CODE BEGIN 2 */
    LL_TIM_EnableIT_UPDATE(TIM2);
    LL_TIM_EnableCounter(TIM2);
    LL_I2C_Enable(I2C1);
    LL_GPIO_SetOutputPin(GPIOA, LL_GPIO_PIN_4);
    LL_GPIO_SetOutputPin(GPIOB, LL_GPIO_PIN_12);
    LL_SPI_Enable(SPI2);
    LL_SPI_Enable(SPI1);
    LL_USART_DisableIT_RXNE(USART2);
    InitInputs();
    //LL_EXTI_EnableRisingTrig_0_31(LL_EXTI_LINE_11);
    //LL_EXTI_EnableRisingTrig_0_31(LL_EXTI_LINE_8);
    //LL_EXTI_EnableRisingTrig_0_31(LL_EXTI_LINE_3);

    /* USER CODE END 2 */

    /* Infinite loop */
    /* USER CODE BEGIN WHILE */
    while(1)
    {
        /* USER CODE END WHILE */

        /* USER CODE BEGIN 3 */
        UpdateAllInputs();
        if(ppsTick == 1U)
        {
            LL_GPIO_TogglePin(GPIOC, LL_GPIO_PIN_13);
            ppsTick = 0U;
        }

        if(enableDisplayLines != 0U)
        {
            LL_GPIO_SetOutputPin(DisplayLine1Ena_GPIO_Port, DisplayLine1Ena_Pin);
            LL_GPIO_SetOutputPin(DisplayLine2Ena_GPIO_Port, DisplayLine2Ena_Pin);
        }
        else
        {
            LL_GPIO_ResetOutputPin(DisplayLine1Ena_GPIO_Port, DisplayLine1Ena_Pin);
            LL_GPIO_ResetOutputPin(DisplayLine2Ena_GPIO_Port, DisplayLine2Ena_Pin);
        }

        if(autoConfigurationDone == 0U)
        {
            RunAutoConfiguration();
        }
        else
        {
            RunRaceTiming();

            UARTBufferRunTxWork();

        }
    }
    /* USER CODE END 3 */
}

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
/* USER CODE BEGIN 4 */

void ProcessUARTByte(uint8_t uartId, uint8_t uartByte)
{
    UARTBufferProcessReceivedByte(UARTBufferGetUART(uartId), uartByte);
}

/* USER CODE END 4 */
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
