boons605/MotoGymkhanaRaceTiming/Timer/Core/Inc/main.h

#define LED_Pin LL_GPIO_PIN_13
#define LED_GPIO_Port GPIOC
#define DisplayLine1Ena_Pin LL_GPIO_PIN_0
#define DisplayLine1Ena_GPIO_Port GPIOB
#define DisplayLine2Ena_Pin LL_GPIO_PIN_1
#define DisplayLine2Ena_GPIO_Port GPIOB
#define SpecialOpMode_Pin LL_GPIO_PIN_10
#define SpecialOpMode_GPIO_Port GPIOB
#define PPS_In_Pin LL_GPIO_PIN_11
#define PPS_In_GPIO_Port GPIOB
#define PPS_In_EXTI_IRQn EXTI15_10_IRQn
#define SensorStartStop_Pin LL_GPIO_PIN_8
#define SensorStartStop_GPIO_Port GPIOA
#define SensorStartStop_EXTI_IRQn EXTI9_5_IRQn
#define OperationMode_Pin LL_GPIO_PIN_8
#define OperationMode_GPIO_Port GPIOB
#define SensorCount_Pin LL_GPIO_PIN_9
#define SensorCount_GPIO_Port GPIOB
#define NVIC_PRIORITYGROUP_0         ((uint32_t)0x00000007) /*!< 0 bit  for pre-emption priority,
#define NVIC_PRIORITYGROUP_1         ((uint32_t)0x00000006) /*!< 1 bit  for pre-emption priority,
#define NVIC_PRIORITYGROUP_2         ((uint32_t)0x00000005) /*!< 2 bits for pre-emption priority,
#define NVIC_PRIORITYGROUP_3         ((uint32_t)0x00000004) /*!< 3 bits for pre-emption priority,
#define NVIC_PRIORITYGROUP_4         ((uint32_t)0x00000003) /*!< 4 bits for pre-emption priority,
