boons605/MotoGymkhanaRaceTiming/Timer/Core/Inc/ConnectedTimestampCollector.h

/*
 * ConnectedTimestampCollector.h
 *
 *  Created on: Jan 10, 2021
 *      Author: cdromke
 */

#ifndef INC_CONNECTEDTIMESTAMPCOLLECTOR_H_
#define INC_CONNECTEDTIMESTAMPCOLLECTOR_H_

void RunConnectedTimestampCollector();

#endif /* INC_CONNECTEDTIMESTAMPCOLLECTOR_H_ */
