boons605/MotoGymkhanaRaceTiming/RiderDetection/Embedded/main/MGBTManager.h

/*
 * MGBTManager.h
 *
 *  Created on: 21 Nov 2020
 *      Author: cdromke
 */

#ifndef MAIN_MGBTMANAGER_H_
#define MAIN_MGBTMANAGER_H_

#include "esp_bt.h"
#include "esp_gap_ble_api.h"

#define MAXDEVICES 64
#define DEVICELISTSCANTIME 5000U
#define DEVICELISTPROGRESSINTERVAL 250U
#define CLOSESTDEVICEANNOUNCEINTERVAL 1000U
#define DEVICELISTCLEANINTERVAL 10000U

typedef enum
{
    MgBtMState_Idle = 0U,
    MgBtMState_ProcessingCommand = 1U,
    MgBtMState_CleaningUpInactive = 2U,
    MgBtMState_ListingAllowedDevices = 3U,
    MgBtMState_ListingAllDetectedDevices = 4U

} ManagerState;

void InitManager(void);
void RunManager(void);
void ProcessScanResult(esp_ble_gap_cb_param_t* scanResult);



#endif /* MAIN_MGBTMANAGER_H_ */
