boons605/MotoGymkhanaRaceTiming/RiderDetection/Embedded/main/MGBTTimeMgmt.h

/*
 * MGBTTimeMgmt.h
 *
 *  Created on: 21 Nov 2020
 *      Author: cdromke
 */

#ifndef MAIN_MGBTTIMEMGMT_H_
#define MAIN_MGBTTIMEMGMT_H_

#include <stdint.h>

uint32_t GetTimestampMs(void);

#endif /* MAIN_MGBTTIMEMGMT_H_ */
