boons605/MotoGymkhanaRaceTiming/Timer/Core/Inc/Max7219DLDWDisplay.h

/*
 * Max7219Display.h
 *
 *  Created on: May 14, 2020
 *      Author: r.boonstra
 */

#ifndef INC_MAX7219DISPLAY_H_
#define INC_MAX7219DISPLAY_H_

#include <stdint.h>

#endif /* INC_MAX7219DISPLAY_H_ */

void UpdateMax7219DLDWDisplay(uint32_t data);
void RunMax7219DLDWDisplay(void);
