boons605/MotoGymkhanaRaceTiming/Timer/Core/Inc/Max7219Display.h

/*
 * Max7219Display.h
 *
 *  Created on: May 14, 2020
 *      Author: r.boonstra
 */

#ifndef INC_MAX7219DISPLAY_H_
#define INC_MAX7219DISPLAY_H_

#include <stdint.h>

#endif /* INC_MAX7219DISPLAY_H_ */

typedef enum
{
    REG_NO_OP 			= 0x00 << 8,
    REG_DIGIT_0 		= 0x01 << 8,
    REG_DIGIT_1 		= 0x02 << 8,
    REG_DIGIT_2 		= 0x03 << 8,
    REG_DIGIT_3 		= 0x04 << 8,
    REG_DIGIT_4 		= 0x05 << 8,
    REG_DIGIT_5 		= 0x06 << 8,
    REG_DIGIT_6 		= 0x07 << 8,
    REG_DIGIT_7 		= 0x08 << 8,
    REG_DECODE_MODE 	= 0x09 << 8,
    REG_INTENSITY 		= 0x0A << 8,
    REG_SCAN_LIMIT 		= 0x0B << 8,
    REG_SHUTDOWN 		= 0x0C << 8,
    REG_DISPLAY_TEST 	= 0x0F << 8,
} MAX7219_REGISTERS;

void UpdateMax7219Display(uint32_t data);
void RunMax7219Display(void);
