boons605/MotoGymkhanaRaceTiming/(commit log)

2020-05-10 Adding files to version control. Resolves #1
    [Configuration.h]
2020-05-10 Starting work on implementation of single sensor lap timer logic #2
    [Configuration.h]
2020-05-10 Adding functionality for #2
    [Configuration.h]
2020-05-12 Implementation of issue #2 and issue #3 and implementation RTC startup/initialization
    [Configuration.h]
2020-05-15 Display (#4), Laptimer bugs (#3)
    [Configuration.c, Display.c, Display.h, LapTimer.c, Max7219Display.c, Max7219Display.h, MotoGymkhanaRaceTiming.ioc, RaceTimeSimulation.ino]
2020-05-23 Display #4
    Dual line, Double wide display
    [Configuration.h]
2020-05-24 Adding PCB files
    [MotoGymkhanaRaceTiming.kicad_pcb, MotoGymkhanaRaceTiming.sch]
2020-05-25 Better PCB, now with jumpers (or headers to wire switches to) for configuration
    [MotoGymkhanaRaceTiming-B_Cu.gbr, MotoGymkhanaRaceTiming-B_Mask.gbr, MotoGymkhanaRaceTiming-B_SilkS.gbr, MotoGymkhanaRaceTiming-Edge_Cuts.gbr, MotoGymkhanaRaceTiming-F_Cu.gbr, MotoGymkhanaRaceTiming-F_Mask.gbr, MotoGymkhanaRaceTiming-F_SilkS.gbr, MotoGymkhanaRaceTiming-NPTH.drl]
2020-05-26 Updated PCB, added board outline
    [MotoGymkhanaRaceTiming-B_Cu.gbr, MotoGymkhanaRaceTiming-B_Mask.gbr, MotoGymkhanaRaceTiming-B_SilkS.gbr, MotoGymkhanaRaceTiming-Edge_Cuts.gbr, MotoGymkhanaRaceTiming-F_Cu.gbr, MotoGymkhanaRaceTiming-F_Mask.gbr, MotoGymkhanaRaceTiming-F_SilkS.gbr, MotoGymkhanaRaceTiming-NPTH.drl]
2020-05-26 Implentation of auto configuration for issue #6
    Display optimizations for #4
    [Configuration.c, Max7219DLDWDisplay.c, Max7219Display.c, MotoGymkhanaRaceTiming.ioc, main.c, main.h]
2020-05-26 #6 - Dual sensor laptimer is not possible.
2020-05-30 Change timer to 100us resolution to achieve millisecond precision in laps #8
2020-06-04 Sensor hardware order list at digikey
    [SensorHardware.csv]
2020-06-04 Adding BOM
    [BOM.csv]
2020-06-04 Updating sensor hardware order list
    [SensorHardware.csv]
2020-06-12 PCB update
    [MotoGymkhanaRaceTiming-B_Cu.gbr, MotoGymkhanaRaceTiming-B_Mask.gbr, MotoGymkhanaRaceTiming-B_SilkS.gbr, MotoGymkhanaRaceTiming-Edge_Cuts.gbr, MotoGymkhanaRaceTiming-F_Cu.gbr, MotoGymkhanaRaceTiming-F_Mask.gbr, MotoGymkhanaRaceTiming-F_SilkS.gbr, MotoGymkhanaRaceTiming-NPTH.drl]
2020-06-13 Update for issue #9
    - Adding text to RTC socket
    - Adding UART2
    - Trace width for 5V net updated
    [MotoGymkhanaRaceTiming.kicad_pcb, MotoGymkhanaRaceTiming.sch]
2020-06-13 Preparations for user interface
    [Configuration.h]
2020-06-13 Update for #9
    - Gerber files for PCB production
    [MotoGymkhanaRaceTiming-B_Cu.gbr, MotoGymkhanaRaceTiming-B_Mask.gbr, MotoGymkhanaRaceTiming-B_SilkS.gbr, MotoGymkhanaRaceTiming-Edge_Cuts.gbr, MotoGymkhanaRaceTiming-F_Cu.gbr, MotoGymkhanaRaceTiming-F_Mask.gbr, MotoGymkhanaRaceTiming-F_SilkS.gbr, MotoGymkhanaRaceTiming-NPTH.drl]
2020-06-20 User interface:
    - Previous times can now be restored using a button.
    [Configuration.h]
2020-11-22 Starting to work on rider detection using BLE iBeacon and ESP32
2020-11-26 Communication protocol works now, can add device to allowed devices list.
2020-11-29 Improved distance calculation, implemented 'get closest device'. Still need to implement some listing packetization functions.
2020-12-04 Added functions to list all devices and list allowed devices Packetization untested
2020-12-06 Implemented cleanup of 'old' devices on the embedded device. Made some improvements to the tester.
2020-12-21 Changed environment factor for calculating distance from average RSSI over 4 samples from 2 to 4, to increase accuracy of distance measurement. Still not accurate at short distances, but good enough 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
    Now just sending closest device every 1 second, to ease testing.
    Also fixed bug where a 'cleared' device would start with an average rssi of 0, which would take 4 samples to clear up. This would mess up the distance exponent and therefore mess up the detection of the device closest to the receiver.
    [MGBTCommProto.c, MGBTDevice.c, MGBTDevice.h, MGBTManager.c, MGBTManager.h]
2020-12-21 adding correction for measured power
    [MGBTDevice.h]
2020-12-21 Added correction factor.
    The PC application is getting uglier and uglier.
    [MGBTDevice.c, MGBTDevice.h, MGBTManager.c]
2020-12-24 Correction factor got lost after a cleanup. Reduced complexity of count functionin manager. All functions now below cyclomatic complexity of 10.
    [MGBTDevice.c, MGBTManager.c]
2020-12-28 Schematic optimizations
    [MotoGymkhanaRaceTiming.kicad_pcb, MotoGymkhanaRaceTiming.sch]
2020-12-28 Creating timer folder
2020-12-28 Moving timer into timer folder
    [BOM.csv, Configuration.h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]
2020-12-29 Issue-10: re-added after ignore
    [BOM.csv, Configuration.h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]
2021-01-03 Issue #17: Adding generic Communication Protocol handlers. This protocol is already built into the embedded part of the Rider ID unit. Since for the timer the embedded part of the communication still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
    It seems most of the plumbing for the Rider ID Unit is now in place.
2021-01-10 STarted working on issue #13 timer communication
    [Configuration.h]
2021-01-11 issue #13 timer communication
    [CommunicationManager.c, CommunicationManager.h, MGBTCommProto.c, MGBTCommProto.h, RaceTiming.c, UARTBuffer.c]
2021-01-13 issue #13 timer communication: It's alive!
    [CommunicationManager.c, MGBTCommProto.c, RaceTiming.c, UARTBuffer.c, main.c]
2021-01-16 issue #13 timer communication: Started implementation of timer unit for central unit
2021-01-17 Issue-18: Programming myself into a corner with json (de)serialization
2021-01-17 issue #13 timer communication: Implementation of thread, introduced more elaborate failure information through event args.
2021-01-18 issue #13 timer communication: Introduced abstract communicating unit, since timer and rider ID unit behave the same when it comes to the plumbing.
2021-01-23 issue #13 timer communication: Further progress, but it doesn't work exactly as expected yet.
2021-01-28 issue #13 timer communication: Further progress, the test seems to be successful. Can get rider ID events and timing events.
2021-01-28 issue #13 timer communication: Stylecop
2021-01-31 issue #13 timer communication: Comments from pull request
2021-02-11 Issue 19: Starting schematics for carrier PCB for rider ID
    [MotoGymkhanaRaceTiming.sch, RiderDetection.kicad_pcb, RiderDetection.sch]
2021-02-13 Issue 19: Schematics for carrier PCB for rider ID
    [RiderDetection.sch]
2021-02-14 Issue 19: Schematics for carrier PCB for rider ID, started PCB
    [RiderDetection.kicad_pcb, RiderDetection.sch]
2021-02-22 Issue 19: Carrier PCB for rider ID
    [RiderDetection.kicad_pcb, RiderDetection.sch]
2021-03-06 Issue 19: Carrier PCB for rider ID, V2 with corrections
    [RiderDetection.kicad_pcb]
2021-03-07 Issue #27: Start light embedded
    [MGBTCommProto.c, MGBTCommProto.h, MGBTManager.c]
2021-03-07 Issue #27: Start light
    [MGBTManager.c]
2021-03-15 Starting issue #29: Carrier PCB for central unit
    [CentralUnit.kicad_pcb, CentralUnit.sch]
2021-03-23 Starting issue #29: Carrier PCB for central unit and improved PCBs for other units, as ordered.
    [CentralUnit-B_Cu.gbr, CentralUnit-B_Mask.gbr, CentralUnit-B_SilkS.gbr, CentralUnit-Edge_Cuts.gbr, CentralUnit-F_Cu.gbr, CentralUnit-F_Mask.gbr, CentralUnit-F_SilkS.gbr, CentralUnit-NPTH.drl]
2021-04-16 Issue #41: Added unit ID to log statements, added some log statements to track application progress, ensured setting of connected flag on Xbee modules, added statement on initialization of Xbee netwo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
2021-04-30 Delayed startup of display drivers
2021-05-01 Issue #46 could also be fixed in software apparently. Software now supports both startup delay and it clears all registers in the display device before initializing.
    [Max7219DLDWDisplay.c, main.c]
2021-05-02 Issue #54: Clear riders on service startup
    [MGBTCommProto.c, MGBTCommProto.h, MGBTManager.c]
2021-05-29 Issue-58: Fixed beacon json (de)serialization
2021-05-29 Issue-58: Fixed some id issues and post laptime in millis instead of micros
2021-06-19 Issue-56: Test Aanpassing
    Dit is een test aanpassing om te kijken hoe ik iets aanpas.
2021-07-10 Fixes #62: Can now control the new display
    [Configuration.h]
2022-12-17 Dit is een test van een wijziging
2022-12-25 Starting work on embedded timer that supports multiple riders
    [Configuration.h]
2022-12-26 Implementation of multi run timer
2022-12-30 Display fixes for multi rider support
    [LapTimer.c, RaceTiming.c]
2023-02-19 kleine verbeteringen aan de code
2023-03-12 Issue-68: added cors to web api, added sample ajax request to main js script
2023-10-28 Issue-68: GetRiders endpoint now respects insert order
2023-11-04 Initialization of single line display, fix earlier applied to dual line make startup more robust by clearing all registers and restarting the max7219 controllers
    [Max7219Display.c]
2023-11-19 Added Trigger Buttons
    In the GUI, you can now manually trigger a gate event with the keyboard keys "a" and "o".
    A = start event
    O = stop event
    Fixed the us/ms problem on UI side (factor 1000)
2023-11-26 Issue-84: ignore end timer events when no riders are on track
2024-02-18 Issue 89: Sending display data would trigger sending latest timestamp because flag was set high
    [CommunicationManager.c]
